konakira/RadioClock/(commit log)

2023-01-16 Trial fix for time went wrong
    It seems that Arduino internal clock was used before
    NTP synchronization completed.
    Added delay after Wi-Fi connection to make NTP Sync complete.
2026-04-12 READMEを少し書き足した。
2026-04-12 図をちょっと変更
2026-04-12 WiFi接続先を複数指定できるようにした。 #include <esp_deep_sleep.h>をやめて#include <esp_sleep.h>にした。 ESP32上のLEDのピン番号をplatformio.iniで指定できるようにした(LED_BUILTIN)。 動作する時刻をplatformio.iniで指定できるようにした(WAKEUP_SCHEDULE)。 西日本に対応した。
2026-04-12 Mac+Emacs環境用に指定を増やした。
2026-04-12 READMEを記載した。
2026-04-12 言い回しと間違いの修正。
2026-04-12 アンテナの作り方の追記
2026-04-12 Platformio Passingを入れた。
2026-04-12 全角丸括弧があったので半角に直した。
2026-04-12 抵抗がささってたのを直した。
2026-04-12 auth.hのことも記載した。
2026-04-16 Update README.md
    nchパワーMOSFETの使用例を2SK2232からより3.3Vでの利用に適したIRLU3410PBFに変更した。
2026-06-09 New Seeed Studio XIAO ESP32-C6 Image
2026-06-09 LC直列共振回路にするためのコンデンサーの追加を追記した。
2026-06-09 Matter版へのリンクを追加した。
2026-06-09 テキスト中の数式の修正
2026-06-09 コンデンサーを挿し込むとなお良いことを追記した。
